Robin-Geissler/EMG-Sensor-Board/Data Sheets/Power Supply/NFM31PC276B0J3L.png

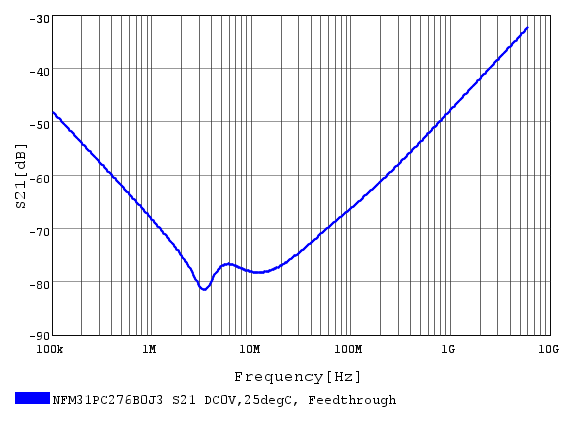
Data Sheets/Power Supply/NFM31PC276B0J3L.png
