Robin-Geissler/EMG-Sensor-Board/Figures/ads1299_config.PNG

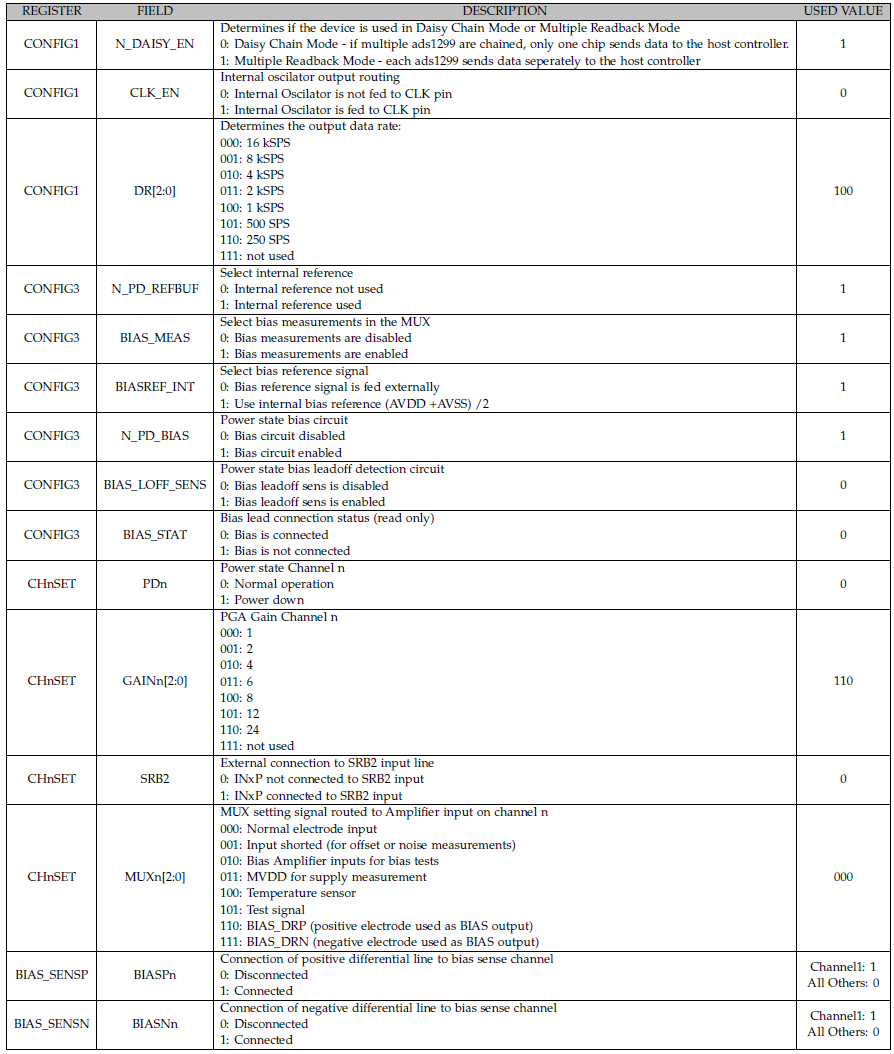
Figures/ads1299_config.PNG
