Robin-Geissler/EMG-Sensor-Board/Figures/8_channel_measurement.PNG

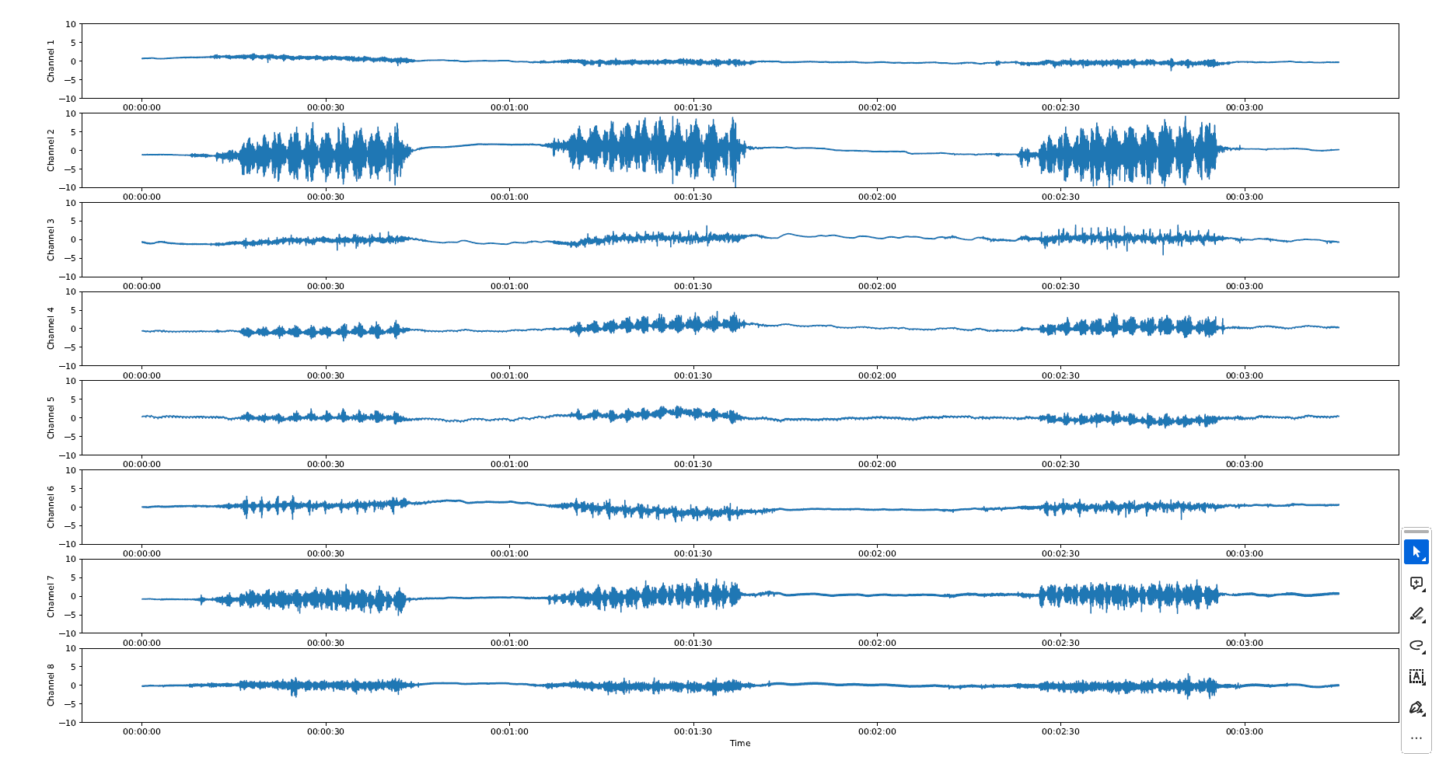
Figures/8_channel_measurement.PNG
