Robin-Geissler/EMG-Sensor-Board/Simulation/ne_measure_Amplitude.pdf

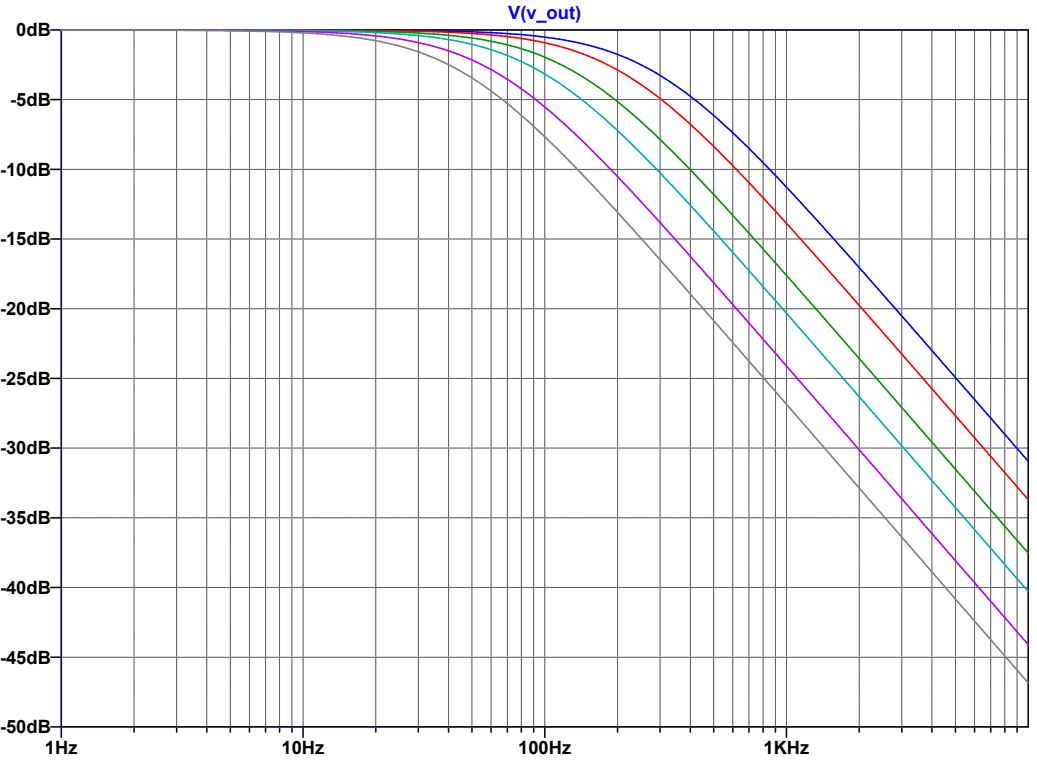
[picture p5: page 1]
1KHz; V(v_out)

--- C:\Projects\emg-sensor_board\Simulation\Filter_RC_Suggested.asc ---
