Robin-Geissler/EMG-Sensor-Board/Simulation/new_measure_Phase.pdf

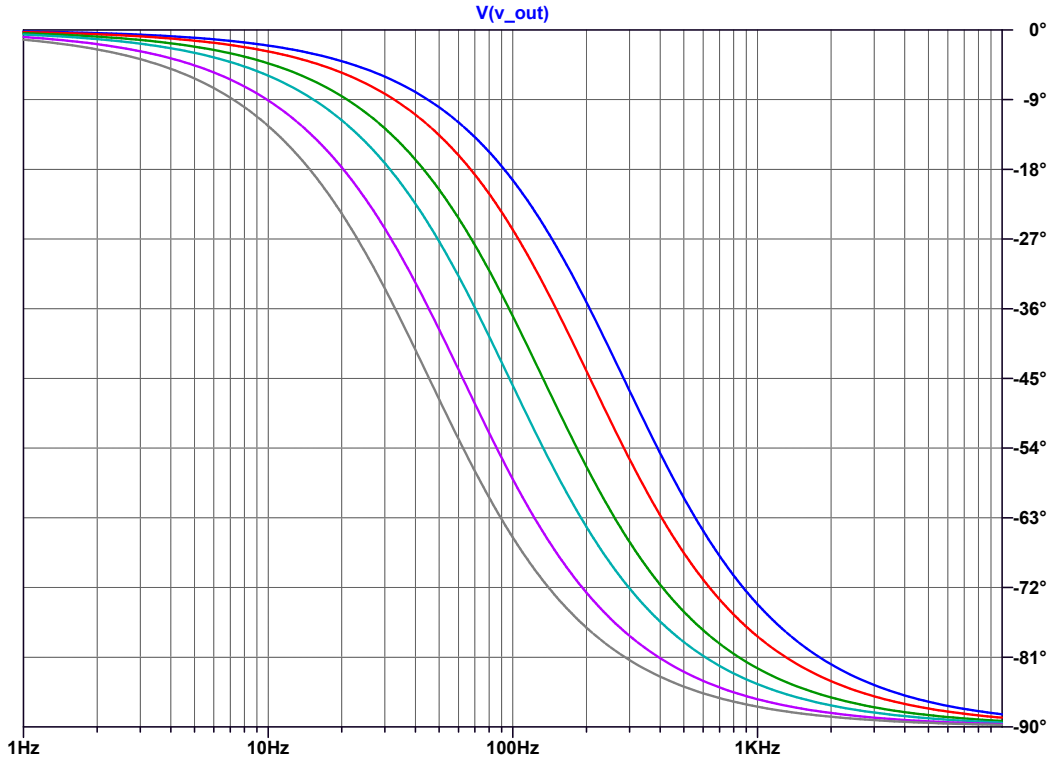
[picture p7: page 1]
1KHz; V(v_out)

--- C:\Projects\emg-sensor_board\Simulation\Filter_RC_Suggested.asc ---
