Robin-Geissler/EMG-Sensor-Board/EMG_Sensor_Board/EMG_Sensor_Board.pdf

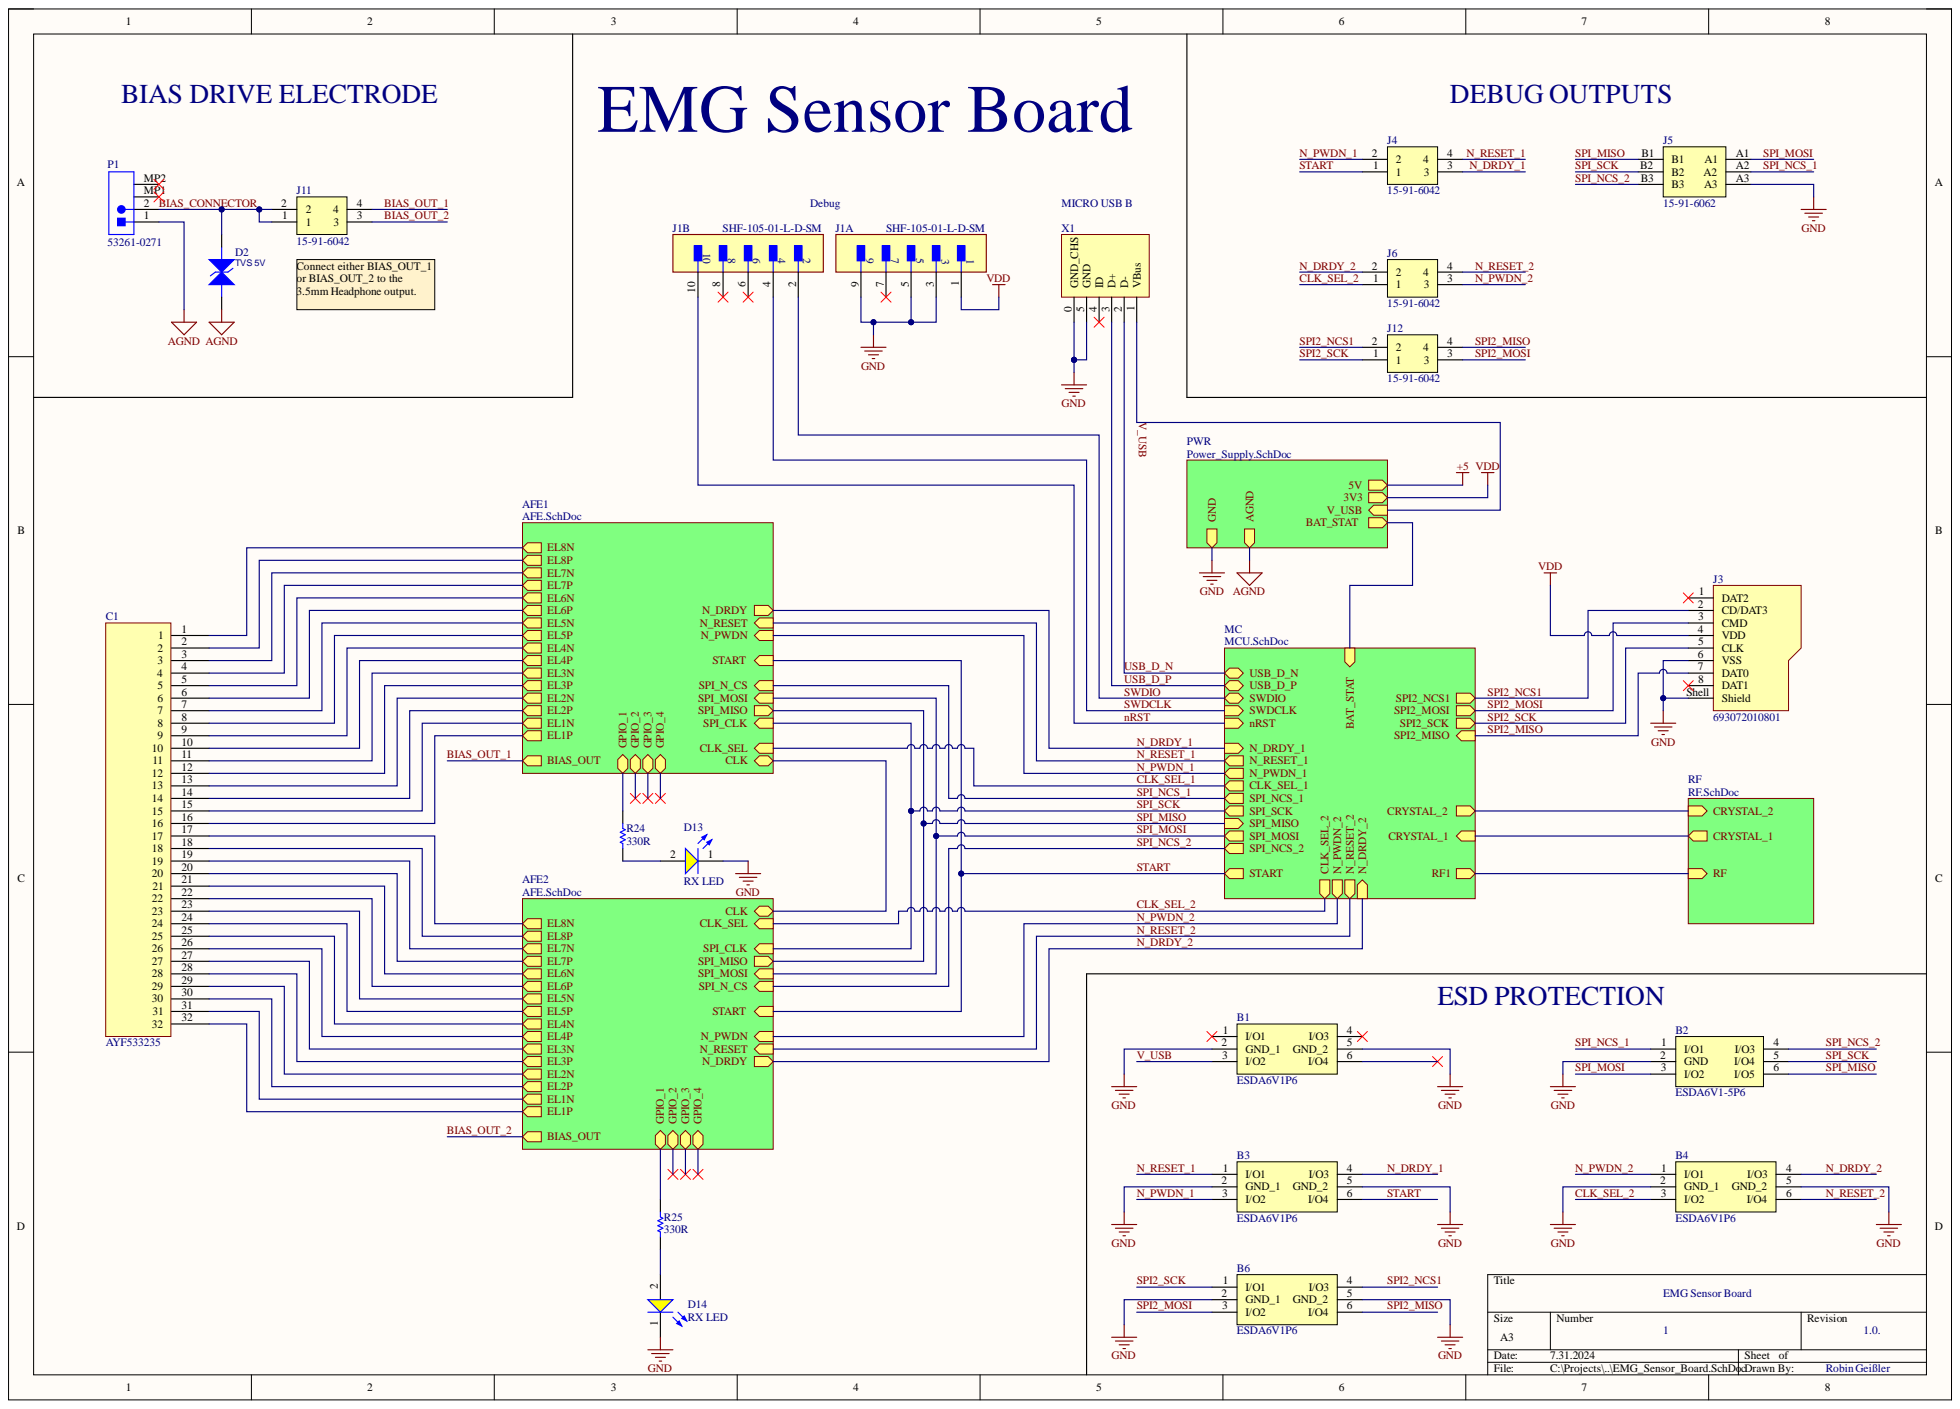
[picture p8: page 1]

5V 3V3 V_USB

BAT_STAT

V_USB | I/O2 3 I/O4 | 6

SPI_MOSI | I/O2 3
