Robin-Geissler/EMG-Sensor-Board/EMG_Sensor_Board/Power_Supply.pdf

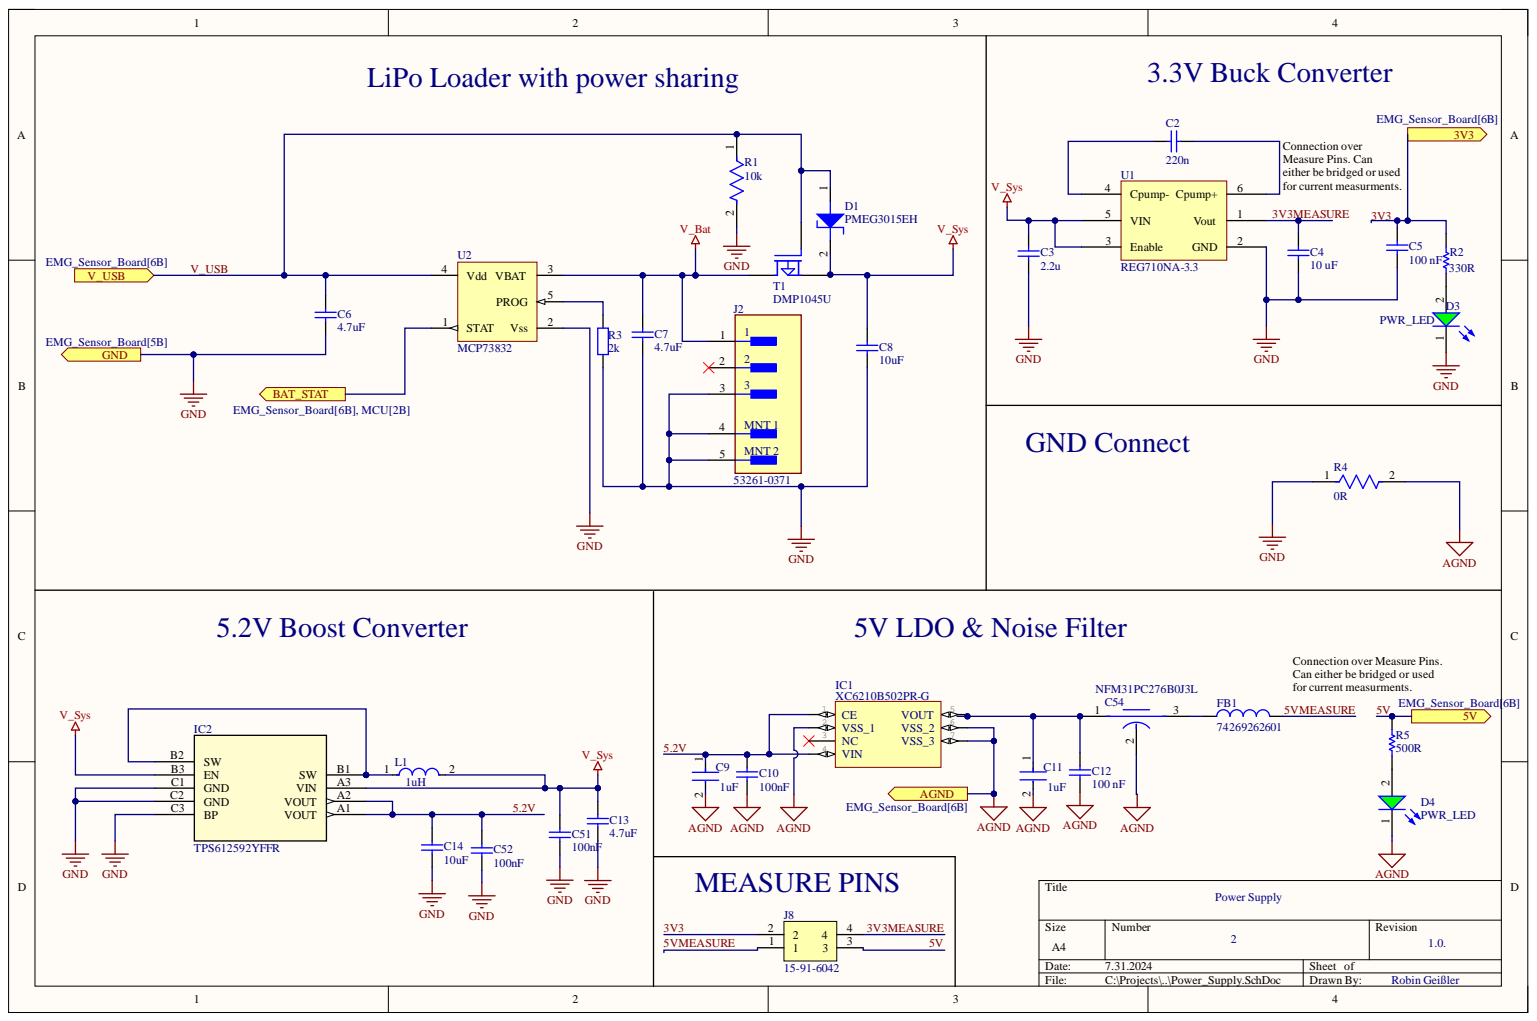
[picture p9: page 1]

LiPo Loader with power sharing

Connection over
Measure Pins. Can
either be bridged or used
for current measurments.

Connection over Measure Pins.
Can either be bridged or used

GND C1
GND C2
BP C3 | 5.2V
