Robin-Geissler/EMG-Sensor-Board/EMG_Sensor_Board/AFE.pdf

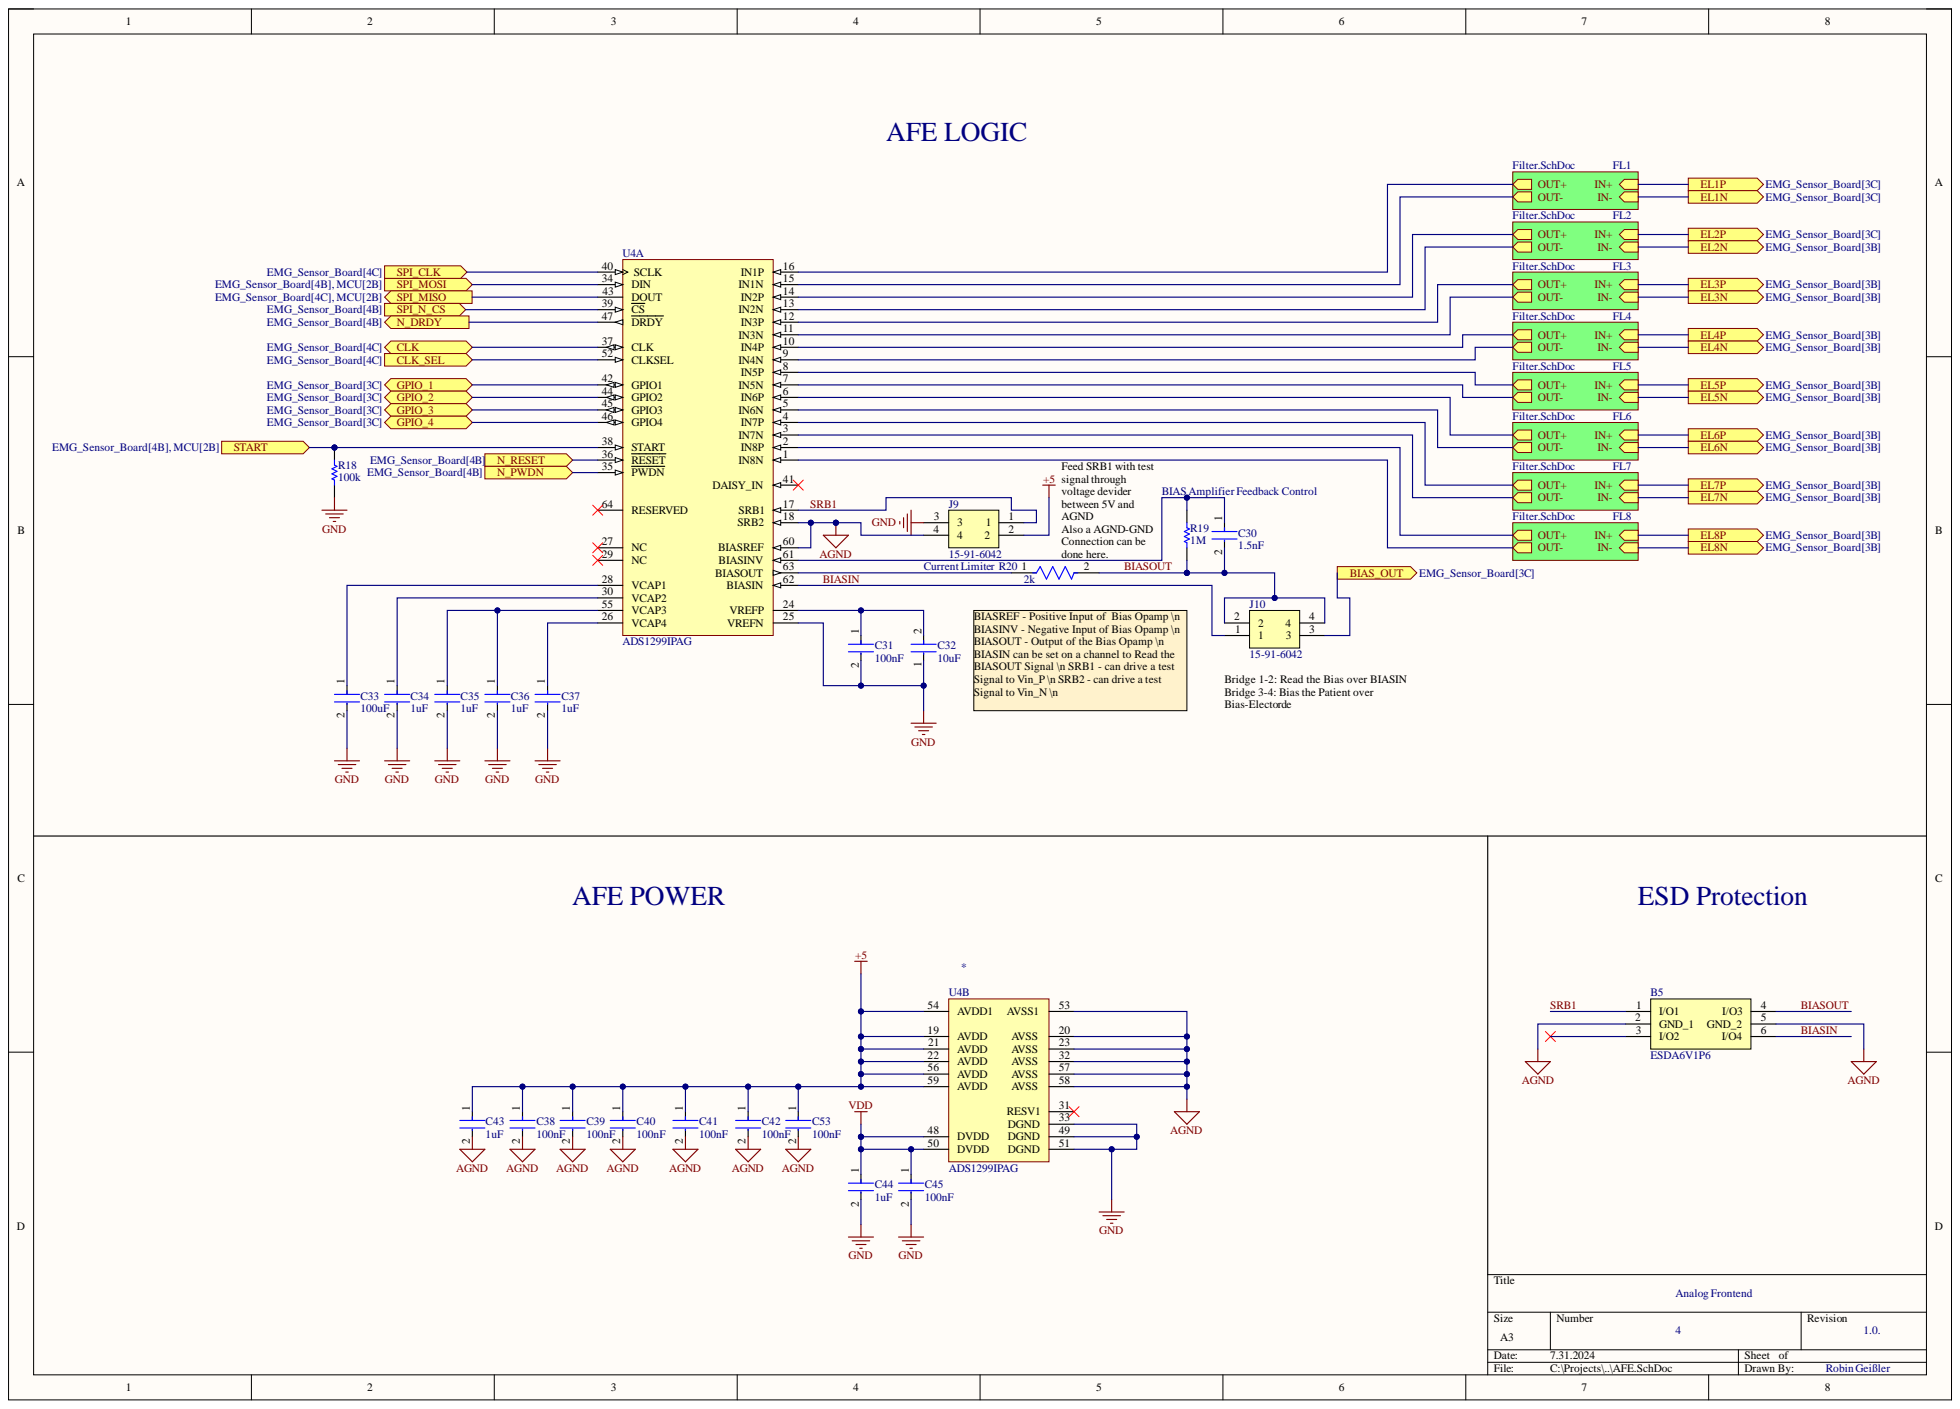
[picture p11: page 1]

BIAS Amplifier Feedback Control

4 4 | OUT+ IN+ OUT-IN-

Connection can be | 1M

BIASREF - Positive Input of Bias Opamp \n
BIASINV - Negative Input of Bias Opamp \n
BIASOUT - Output of the Bias Opamp \n
BIASIN can be set on a channel to Read the
BIASOUT Signal \n SRB1 - can drive a test
Signal to Vin_P \n SRB2 - can drive a test
Signal to Vin_N \n

Bridge 1-2: Read the Bias over BIASIN
Bridge 3-4: Bias the Patient over
Bias-Electorde
