Robin-Geissler/EMG-Sensor-Board/EMG_Sensor_Board/Filter.pdf

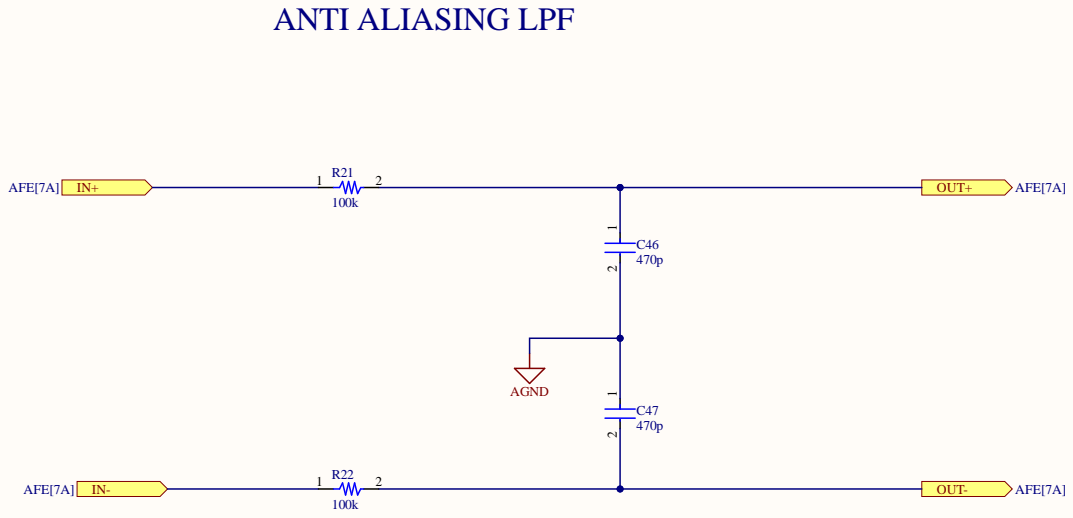
[picture p12: page 1]
