Robin-Geissler/EMG-Sensor-Board/EMG_Sensor_Board/MCU.pdf

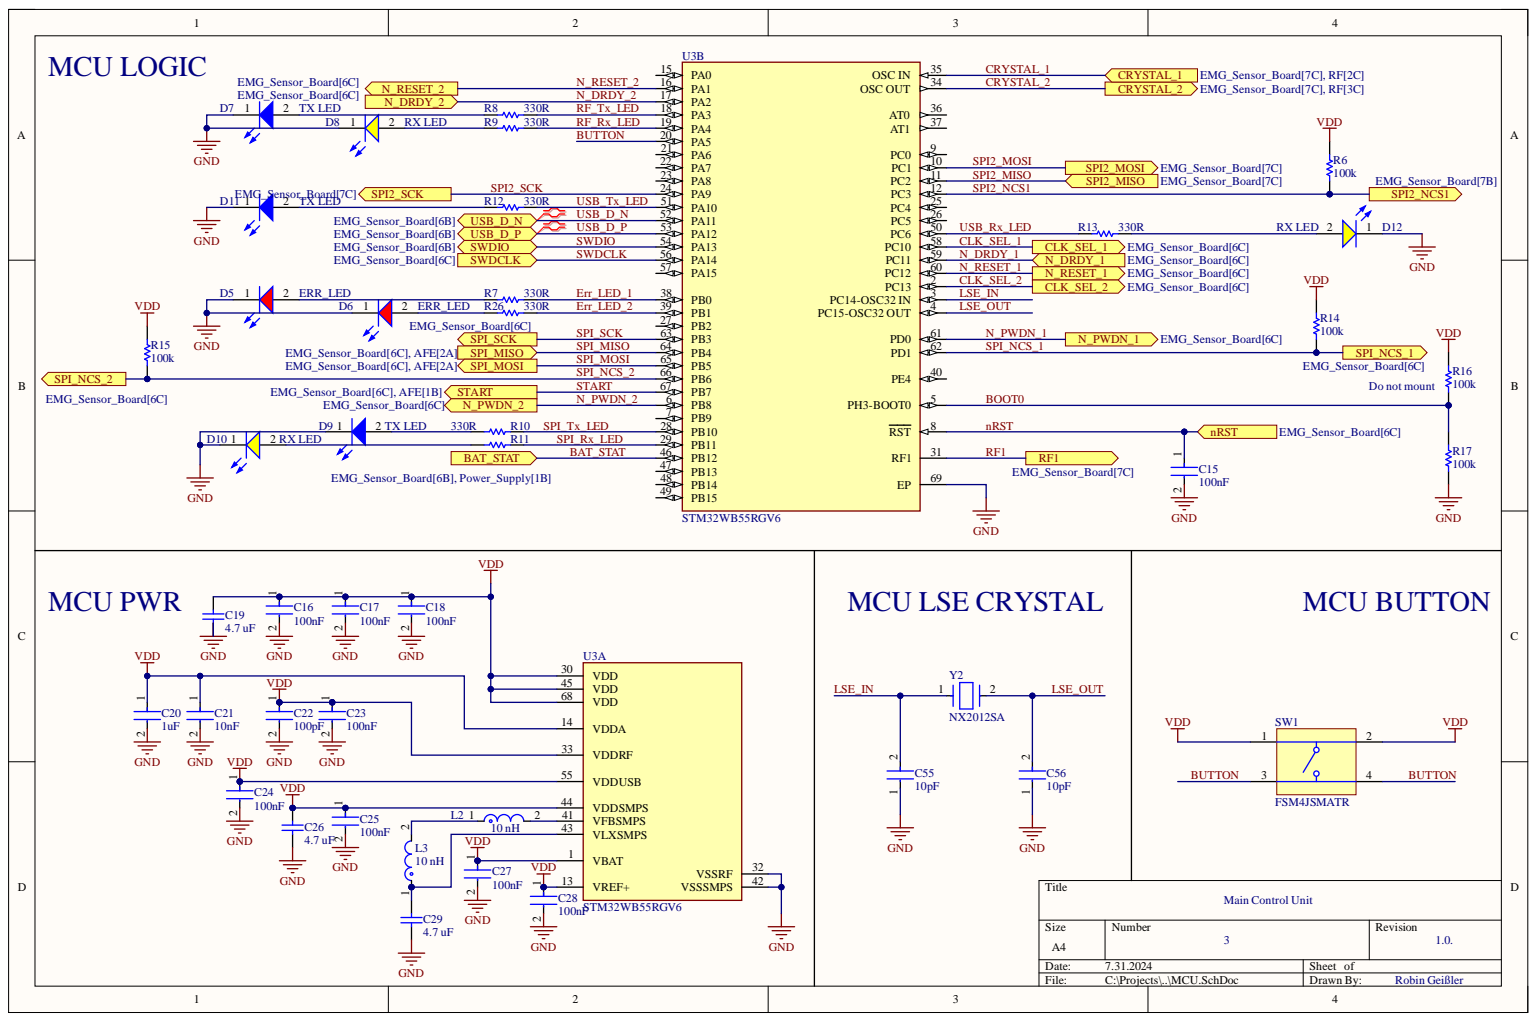
[picture p13: page 1]

VDD 68

VDDA 14

VDDSMPS 44
VFBSMPS 41 VLXSMPS 43

VDD | | VBAT 1
