Robin-Geissler/EMG-Sensor-Board/EMG_Sensor_Board/RF.pdf

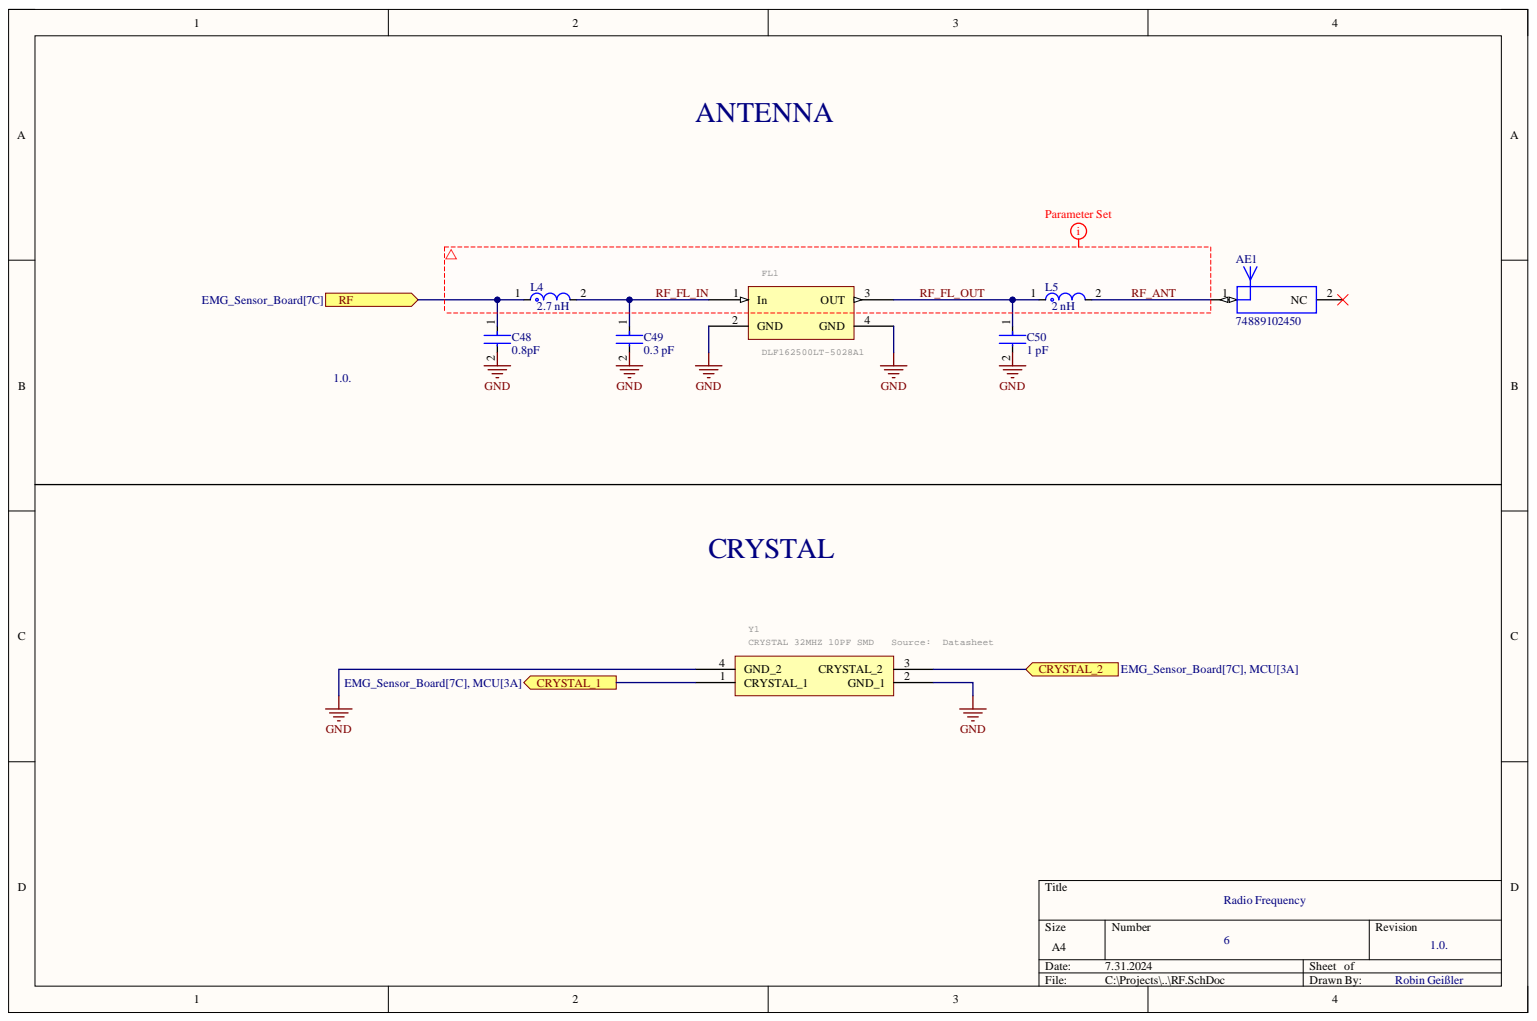
[picture p14: page 1]
