Robin-Geissler/EMG-Sensor-Board/Simulation/Filter_RC_Suggested.asc

C1: cap; {Y}
C2: cap; {Y}
R1: res; 1000Meg
R2: res; {X}
R3: res; {X}
V1: voltage; ""; AC 1; Rser=500k
Named nets: V_out, V_in, 0
.ac dec 100 1 10k
.step param X list 4.99k 100k
.step param Y list 2.2n 4.7n 10n
