Robin-Geissler/EMG-Sensor-Board/Simulation/Filter_RC_Optimal.asc

C1: cap; 318p
C2: cap; 318p
R1: res; 1000Meg
R2: res; 500k
R3: res; 500k
V1: voltage; ""; AC 1; Rser=500k
Named nets: 0, V_out, V_in
.ac dec 100 1 10k
