Robin-Geissler/EMG-Sensor-Board/(list of files, drawings)

Other design files:
EMG_Sensor_Board/AFE.SchDoc
EMG_Sensor_Board/EMG_Sensor.PcbLib
EMG_Sensor_Board/EMG_Sensor.SchLib
EMG_Sensor_Board/EMG_Sensor_Board.PrjPcb
EMG_Sensor_Board/EMG_Sensor_Board.SchDoc
EMG_Sensor_Board/Filter.SchDoc
EMG_Sensor_Board/MCU.SchDoc
EMG_Sensor_Board/PCB1.PcbDoc
EMG_Sensor_Board/Power_Supply.SchDoc
EMG_Sensor_Board/RF.SchDoc
