Robin-Geissler/EMG-Sensor-Board/Software/Core/Src/main.c

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
/* Includes ------------------------------------------------------------------*/
#include "main.h"
#include "app_fatfs.h"
#include "usb_device.h"

/* USER CODE BEGIN Includes */
#include <string.h>
#include "ads1299.h"
#include "usbd_cdc_if.h"
#include "ff_gen_drv.h"
#include "sd_diskio.h"
/* USER CODE END Includes */

/* USER CODE BEGIN PD */
#define BUFFER1 0
#define BUFFER2 1
/* USER CODE END PD */

RTC_HandleTypeDef hrtc;

SPI_HandleTypeDef hspi1;
SPI_HandleTypeDef hspi2;
DMA_HandleTypeDef hdma_spi1_tx;
DMA_HandleTypeDef hdma_spi1_rx;

TIM_HandleTypeDef htim1;
TIM_HandleTypeDef htim2;

/* USER CODE BEGIN PV */
uint8_t *dataReading;
int32_t dataProcessed[8];
char adc_data_str_buff1[60000];
char adc_data_str_buff2[60000];
char adc_data_str[200];
uint32_t adc_data_count = 0;
uint8_t WRITEBUFFER = BUFFER1;
uint8_t LOCK1 = 0;
uint8_t FULL1 = 0;
uint8_t LOCK2 = 0;
uint8_t FULL2 = 0;
uint8_t RUN = 0;
uint8_t DEMOUNT = 0;
uint8_t MOUNT = 0;
uint32_t timeMeasure[10];
uint32_t buff_i = 0;

/* SD Card*/
FRESULT res;
FIL myFile;

RTC_TimeTypeDef stime;
RTC_DateTypeDef sdate;

char log_file[32] = "Log.csv";

/* USER CODE END PV */

void SystemClock_Config(void);
void PeriphCommonClock_Config(void);
static void MX_GPIO_Init(void);
static void MX_DMA_Init(void);
static void MX_SPI1_Init(void);
static void MX_SPI2_Init(void);
static void MX_RTC_Init(void);
static void MX_TIM2_Init(void);
static void MX_TIM1_Init(void);
/* USER CODE BEGIN PFP */

int16_t FS_FILE_Write(char *data);
FRESULT sd_mount(void);
FRESULT sd_unmount(void);
void buttonTask(void);

/* USER CODE END PFP */

/**
  * @brief  The application entry point.
  * @retval int
  */
int main(void)
{
  /* MCU Configuration--------------------------------------------------------*/

  /* Reset of all peripherals, Initializes the Flash interface and the Systick. */
  HAL_Init();

  /* Configure the system clock */
  SystemClock_Config();

/* Configure the peripherals common clocks */
  PeriphCommonClock_Config();

  /* Initialize all configured peripherals */
  MX_GPIO_Init();
  MX_DMA_Init();
  MX_SPI1_Init();
  MX_SPI2_Init();
  if (MX_FATFS_Init() != APP_OK) {
    Error_Handler();
  }
  MX_USB_Device_Init();
  MX_RTC_Init();
  MX_TIM2_Init();
  MX_TIM1_Init();
  /* USER CODE BEGIN 2 */
	
	/* Init SD Card*/
	BSP_SD_Init();
	
	/* Enable Timer for LEDs */
	HAL_TIM_OC_Start(&htim1, 1);
	
	/* ADS1299 Initialization */
	ADS1299_Init(&hspi1, SPI1_NCS1_GPIO_Port, SPI1_NCS1_Pin, CLK_SEL_1_GPIO_Port, CLK_SEL_1_Pin, false, 
	N_PWDN_1_GPIO_Port , N_PWDN_1_Pin, N_RESET_1_GPIO_Port, N_RESET_1_Pin);
  
	/* activate conversion */
	HAL_GPIO_WritePin(START_GPIO_Port, START_Pin, GPIO_PIN_SET);
	HAL_Delay(100);
	
	
	
  /* USER CODE END 2 */

  /* Infinite loop */
  /* USER CODE BEGIN WHILE */
  while (1)
  {		
			/* SD-Card Writing was activated by button push */
			if(MOUNT){
				/* Init Write file */
				/* Mount SD Card */
				res = sd_mount();
				/* Check if mounting was successfull */
				if(res != FR_OK) {
					HAL_GPIO_WritePin(Error_LED_1_GPIO_Port, Error_LED_1_Pin, GPIO_PIN_SET);
				}
				
				/* Open file in append and write mode */
				res = f_open(&myFile, log_file, FA_OPEN_APPEND | FA_WRITE);
				/* Check if file opening was successfull */
				if(res != FR_OK) {
					HAL_GPIO_WritePin(Error_LED_1_GPIO_Port, Error_LED_1_Pin, GPIO_PIN_SET);
					sd_unmount();
				}
				
				/* Mount was successfull, deactivate MOUNT Flag */
				MOUNT = 0;
				
				/* Write header line to file */
				FS_FILE_Write("timestamp;value1;value2;value3;value4;value5;value6;value7;value8\n");
			}
			
			/* SD Card Writing is active */
			if(RUN){
				/*
				 * Write one of the two write buffers to the sd card. One of the two FULL
				 * Flags is set at any time, the other one is false. The full buffer is
				 * written to the sd-card. The other buffer is filled with new measurement
				 * data at the same time by an interrrupt with higher priority (HAL_SPI_TxRxCpltCallback).
				 */
				if(FULL1){
				/* Mark start write */
				HAL_GPIO_WritePin(SPI_Tx_LED_GPIO_Port, SPI_Tx_LED_Pin, GPIO_PIN_SET);
				/* Write SD Card */
				FS_FILE_Write(adc_data_str_buff1);
				/* Empty data buffer */
				strncpy(adc_data_str_buff1, "",1);
				/* Mark buffer as emptied */
				FULL1 = 0;
				/* Mark write finished */
				HAL_GPIO_WritePin(SPI_Tx_LED_GPIO_Port, SPI_Tx_LED_Pin, GPIO_PIN_RESET);
				}
				if(FULL2){
				/* Mark start write */
  			HAL_GPIO_WritePin(SPI_Tx_LED_GPIO_Port,  SPI_Tx_LED_Pin, GPIO_PIN_SET);
				/* Write SD Card */
				FS_FILE_Write(adc_data_str_buff2);
				/* Empty data buffer */
				strncpy(adc_data_str_buff2, "",1);
				/* Mark buffer as emptied */
				FULL2 = 0;
				/* Mark write finished */
				HAL_GPIO_WritePin(SPI_Tx_LED_GPIO_Port, SPI_Tx_LED_Pin, GPIO_PIN_RESET);
				}
			}
			
			/* SD-Card Writing was deactivated by button push */
			if(DEMOUNT){
				/* Close write file */
				res = f_close(&myFile);
				/* Unmount SD Card*/
				res = sd_unmount();
				/* DEMOUNT was successfull, deactivate DEMOUNT Flag */
				DEMOUNT = 0;
			}
		
    /* USER CODE END WHILE */

    /* USER CODE BEGIN 3 */
  }
  /* USER CODE END 3 */
}

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
/* USER CODE BEGIN 4 */

/*
 * SPI TxCplt Callback
 */
void HAL_SPI_TxCpltCallback(SPI_HandleTypeDef *hspi){
		
	if(hspi == &hspi1){
		HAL_GPIO_WritePin(SPI1_NCS1_GPIO_Port, SPI1_NCS1_Pin, GPIO_PIN_SET);
		HAL_GPIO_WritePin(SPI1_NCS2_GPIO_Port, SPI1_NCS2_Pin, GPIO_PIN_SET);
	}
	if(hspi == &hspi2){
//		HAL_GPIO_WritePin(SPI2_NCS1_GPIO_Port, SPI2_NCS1_Pin, GPIO_PIN_SET);
	}
	// timing requirements
//	HAL_Delay(50);
}


/*
 * SPI TxRxCplt Callback
 */
void HAL_SPI_TxRxCpltCallback(SPI_HandleTypeDef *hspi){
	/* Measurement data was read*/	
	if(hspi == &hspi1){
			
		/* Deactivat SPI CS Pins */	
		HAL_GPIO_WritePin(SPI1_NCS1_GPIO_Port, SPI1_NCS1_Pin, GPIO_PIN_SET); // Pin 1
//	HAL_GPIO_WritePin(SPI1_NCS2_GPIO_Port, SPI1_NCS2_Pin, GPIO_PIN_SET); // Pin 2
			
		/* Convert ADS1299 data format to uint32_t */
		ADS1299_Convert_Data(dataReading,dataProcessed);
		/* Send measurement data over USB interface for live plotting */
		CDC_Transmit_FS((uint8_t*)dataProcessed,32);

		/* If active running is deactivated data is not saved */
		if(!RUN){
			return;
		}
		
		/* Create a timestamp */
		HAL_RTC_GetTime(&hrtc, &stime, RTC_FORMAT_BCD);
		HAL_RTC_GetDate(&hrtc, &sdate,RTC_FORMAT_BCD);
		
		
		/* Write into Buffer. Write either Buffer 1 or Buffer 2*/	
		/* Write to Buffer 1 */
		if(WRITEBUFFER == BUFFER1){
			/* Create formatstring in CSV data format */
			sprintf(adc_data_str_buff1 + buff_i,"%x-%x-%x-%03d;%d;%d;%d;%d;%d;%d;%d;%d \n", stime.Hours, stime.Minutes, stime.Seconds, 999 - (stime.SubSeconds * 1000 / 1024), dataProcessed[0],dataProcessed[1],dataProcessed[2],dataProcessed[3],dataProcessed[4],dataProcessed[5],dataProcessed[6],dataProcessed[7]);
			
			do{
				buff_i++;
			}while(adc_data_str_buff1[buff_i] != NULL);
		}
		
		
		/* Write to Buffer 2 */
		if(WRITEBUFFER == BUFFER2){
			sprintf(adc_data_str_buff2 + buff_i,"%x-%x-%x-%03d;%d;%d;%d;%d;%d;%d;%d;%d \n", stime.Hours, stime.Minutes, stime.Seconds, 999 - (stime.SubSeconds * 1000 / 1024), dataProcessed[0],dataProcessed[1],dataProcessed[2],dataProcessed[3],dataProcessed[4],dataProcessed[5],dataProcessed[6],dataProcessed[7]);
			/* set buff_i to the end of the buffer */
			do{
				buff_i++;
			}while(adc_data_str_buff2[buff_i] != NULL);
		}
		
		/* increase data counter */
		adc_data_count++;
		

		/* if a buffer is full (300 values) switch the buffer*/
		if(adc_data_count >= 300){
			/* Mark current buffer as FULL*/
			if(WRITEBUFFER == BUFFER1){
				FULL1 = 1;
			}
			if(WRITEBUFFER == BUFFER2){
				FULL2 = 1;
			}
			
			/* Set new WRITEBUFFER*/
			if(!FULL1){
					WRITEBUFFER = BUFFER1;
			}
			else if(!FULL2){
					WRITEBUFFER = BUFFER2;
			}else{
					/* Error if Both Buffers are occupied -> timing Issue*/
					HAL_GPIO_WritePin(Error_LED_1_GPIO_Port, Error_LED_1_Pin, GPIO_PIN_SET);
			}
			/* Reset buffer end point */
			buff_i = 0;
			/* Reset data counter */
			adc_data_count = 0;
		}
	}
	
	/* SPI 2 was Read */
	if(hspi == &hspi2){
			/*Implement here what should happen after spi2 read*/
	}
}


/*
 * SPI EXTI Callback
 */
void HAL_GPIO_EXTI_Callback(uint16_t GPIO_Pin){
		switch(GPIO_Pin){
			case N_DRDY_1_Pin:
//				ADS1299_WriteRegister(GPIO, 0xF0);	
				dataReading = ADS1299_RDATA();	
			
				
//				CDC_Transmit_FS((uint8_t*)"hi", 2);
				
//				ADS1299_WriteRegister(GPIO, 0x00);
				break;
			case N_DRDY_2_Pin:
				ADS1299_WriteRegister(GPIO, 0xF0);
				break;
			case Button_Pin:
				 buttonTask();
				break;
			default:
				break;
		}
}

void HAL_TIM_OC_DelayElapsedCallback(TIM_HandleTypeDef *htim){ 
	HAL_GPIO_TogglePin(SPI_Rx_LED_GPIO_Port, SPI_Rx_LED_Pin);
}



/**
* @brief  write data to the file
* @param  filename
* @param  data
* @return status int16_t: bytes_written < 0, FRESULT >=0
*/
int16_t FS_FILE_Write(char *data) {
	FRESULT res;
	
	uint16_t bytes_written;
 
	// 2. write data to file
	// res = f_write(&myFile, data, strlen(data), (void *)&bytes_written);
	bytes_written = f_puts(data, &myFile);
	
	// 5. return status: bytes_written < 0, FRESULT >=0
	return -1 * bytes_written;
}
 
 
/**
* @brief  mount uSD card
* @return FRESULT
*/
FRESULT sd_mount(void) {
	FRESULT res = f_mount(&SDFatFs, SDPath, 1);
	//HAL_Delay(10);
	return res;
}
 
 
/**
* @brief  unmount uSD card
* @return FRESULT
*/
FRESULT sd_unmount(void) {
	return f_mount(0, SDPath, 0);
}

void buttonTask(void){
	
	/* Software debounce*/
	HAL_Delay(10);
	if(!HAL_GPIO_ReadPin(Button_GPIO_Port,  Button_Pin)) return;
	
	/* if not running start run*/
	if(!RUN){
		/* initialize a run*/
		MOUNT = 1;
		RUN = 1;
		
		/* reset time*/
		stime.Hours = 0;
		stime.Minutes = 0;
		stime.Seconds = 0;
		stime.SubSeconds = 0;
		HAL_RTC_SetTime(&hrtc, &stime, RTC_FORMAT_BCD);
		
		/* re-init writing variables*/
		WRITEBUFFER = BUFFER1;
		buff_i = 0;
		adc_data_count = 0;
		
		/* mark running*/
		HAL_GPIO_WritePin(SPI_Rx_LED_GPIO_Port, SPI_Rx_LED_Pin, GPIO_PIN_SET);
		
		return;
	}
	
	
	/* If running, stop run*/
	if(RUN){
		RUN = 0;
		DEMOUNT = 1;
		
		/* RESET Error*/
  	HAL_GPIO_WritePin(Error_LED_1_GPIO_Port, Error_LED_1_Pin, GPIO_PIN_RESET);
		
		/* Mark Not Running*/
		HAL_GPIO_WritePin(SPI_Rx_LED_GPIO_Port, SPI_Rx_LED_Pin, GPIO_PIN_RESET);
		return;
	}
	
}
/* USER CODE END 4 */
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
