Robin-Geissler/EMG-Sensor-Board/(commit log)

2024-01-19 inits project, adds STM
    [AFE.SchDoc, EMG_Sensor_Board.PrjPcb, EMG_Sensor_Board.SchDoc, MCU.SchDoc, Power_Supply.SchDoc]
2024-01-23 adds Power supply (finished), AFE (not finished), MCU (not finished)
    [AFE.SchDoc, EMG_Sensor_Board.PrjPcb, EMG_Sensor_Board.SchDoc, MCU.SchDoc, Power_Supply.SchDoc, USB_C.SchDoc]
2024-01-24 some changes on AFEs
    [AFE.SchDoc, MCU.SchDoc, Power_Supply.SchDoc, USB_C.SchDoc]
2024-01-26 changes on mcu and init of ioc file
    [EMG_Sensor_Board.PrjPcb, EMG_Sensor_Board.SchDoc, MCU.SchDoc, PCB1.PcbDoc, Power_Supply.SchDoc]
2024-01-26 adds basics for battery loader
    [Power_Supply.SchDoc]
2024-02-02 new power supply 5.2V
    [AFE.SchDoc, DSBGA09_1P206X1P306_TEX.step, EDI2CAP.CFG, PADS Libraries.PrjPcb, Power_Supply.SchDoc, TPS612592YFFR.PcbLib, TPS612592YFFR.SchLib, XC6210B502PR-G.Library.PrjPcb]
2024-02-06 adds basic simulation for Signal Filters
    [AFE.SchDoc, Power_Supply.SchDoc, XC6210B502PR-G.Library.PrjPcb, XC6210B502PR-G.PCBLIB, XC6210B502PR-G.SCHLIB]
2024-02-07 exchanges stm32 SOC with STM32 Microcontroller that has different package
    [AFE.SchDoc, MCU.SchDoc]
2024-02-08 work on AFE, and STM32
    [AFE.SchDoc, MCU.SchDoc, Power_Supply.SchDoc, USB_C.SchDoc]
2024-02-11 adds RF circuitry
    [DLF162500LT-5028A1.Library.PrjPcb, DLF162500LT-5028A1.PCBLIB, DLF162500LT-5028A1.SCHLIB, DLF162500LT-5028A1.stp, EDI2CAP.CFG, EMG_Sensor_Board.SchDoc, MCU.SchDoc, NX2016SA-32M-EXS00A-CS06465.Library.PrjPcb]
2024-02-15 starts connecting main sheet
    [AFE.SchDoc, EMG_Sensor.SchLib, EMG_Sensor_Board.PrjPcb, EMG_Sensor_Board.SchDoc, ENG_Sensor.PcbLib, Filter.SchDoc, MCU.SchDoc, PcbLib1.PcbLib]
2024-02-16 changes in EMG Sensor Library
    [AFE.SchDoc, EMG_Sensor.SchLib, EMG_Sensor_Board.PrjPcb, EMG_Sensor_Board.SchDoc, ENG_Sensor.PcbLib, Filter.SchDoc, MCU.SchDoc, Power_Supply.SchDoc]
2024-02-17 adds connections in main sheet
    [AFE.SchDoc, EMG_Sensor_Board.SchDoc, MCU.SchDoc, RF.SchDoc]
2024-02-19 adds RLD circuit, measurment headers, LEDs
    [AFE.SchDoc, EMG_Sensor.SchLib, EMG_Sensor_Board.SchDoc, Filter.SchDoc, MCU.SchDoc, Power_Supply.SchDoc]
2024-02-19 adds changes in simulation comparing option with low tolerance resistors
2024-02-19 adds LEDs in software configuration
2024-02-19 updates filter simulation
2024-02-20 adds Electrode Connector
    [AYF531635.Library.PrjPcb, AYF531635.PCBLIB, AYF531635.PcbLib, AYF531635.SCHLIB, AYF531635.SchLib, AYF531635.stp, EDI2CAP.CFG, EMG_Sensor.SchLib]
2024-02-20 adds connector for Bias Drive, some caps in power supply, general organization
    [AFE.SchDoc, EDI2CAP.CFG, EMG_Sensor.SchLib, EMG_Sensor_Board.PrjPcb, EMG_Sensor_Board.SchDoc, ENG_Sensor.PcbLib, Filter.SchDoc, MCU.SchDoc]
2024-02-21 resolves D1 footprint issue
    [EMG_Sensor.SchLib, EMG_Sensor_Board.PrjPcb, ENG_Sensor.PcbLib, Power_Supply.SchDoc]
2024-02-22 5.2V Caps, ESD Protection, Footprint correction for precision resistor...
    [EMG_Sensor.SchLib, EMG_Sensor_Board.PrjPcb, EMG_Sensor_Board.SchDoc, ENG_Sensor.PcbLib, Filter.SchDoc, MCU.SchDoc, Power_Supply.SchDoc]
2024-02-27 routing AFEs, Filters, MCU
    [AFE.SchDoc, EMG_Sensor_Board.PrjPcb, EMG_Sensor_Board.SchDoc, Filter.SchDoc, MCU.SchDoc, Power_Supply.SchDoc]
2024-02-28 part placement Power, RF, Routing Input Signals, Boardshape, Board Compression
    [ENG_Sensor.PcbLib, Power_Supply.SchDoc]
2024-02-29 new bias electrode connector, some Power Routing
    [EMG_Sensor_Board.PrjPcb, EMG_Sensor_Board.SchDoc]
2024-03-01 space optimization, power routing
    [Power_Supply.SchDoc]
2024-03-04 routing spi
    [AFE.SchDoc, EMG_Sensor_Board.SchDoc, MCU.SchDoc]
2024-03-05 routing of ESD protection + RF Final
    [EMG_Sensor_Board.SchDoc, RF.SchDoc]
2024-03-08 adds descriptions on silk screen + some rule violation resolvements
    [EMG_Sensor_Board.PrjPcb, EMG_Sensor_Board.SchDoc, ENG_Sensor.PcbLib]
2024-03-11 adds testing LEDs for AFEs
    [EMG_Sensor_Board.SchDoc]
2024-03-14 new LTSpice filter simulation + lettle changes in layout from ferdis design review (more changes to come)
    [EMG_Sensor_Board.PrjPcb]
2024-03-15 adds SD Card connector and rearranges DEBUG Connector and LEDs
    [AFE.SchDoc, EMG_Sensor_Board.SchDoc, MCU.SchDoc, Power_Supply.SchDoc, RF.SchDoc]
2024-03-18 some DRC Error resolvement
    [Software.ioc]
2024-03-19 new button + spi2 debug connectors
    [EMG_Sensor_Board.PrjPcb, EMG_Sensor_Board.SchDoc, MCU.SchDoc]
2024-03-21 rearrangement of power supply for clear Analog Digital separation, adds LS Crystal for realtime clock, adds more filtering to 5V PWR over broader frequency span
    [AFE.SchDoc, EMG_Sensor.SchLib, EMG_Sensor_Board.PrjPcb, EMG_Sensor_Board.SchDoc, ENG_Sensor.PcbLib, MCU.SchDoc, Power_Supply.SchDoc]
2024-03-24 new naming of files, and annotation of the pcb
    [EMG_Sensor.PcbLib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]
2024-03-24 adds output job
    [AFE.SchDoc, EMG_Sensor.PcbLib, EMG_Sensor_Board.SchDoc, Filter.SchDoc, MCU.SchDoc, Power_Supply.SchDoc, RF.SchDoc]
2024-04-02 resolves issues with part drawings on multiple layers in library
    [EMG_Sensor.PcbLib, EMG_Sensor_Board.PrjPcb]
2024-05-07 generated setup software, implemented general read and write functions for the AFEs over SPI
2024-05-10 spi signal configured with dma, power up or signal still not correct
    [Software.ioc, ads1299.c, main.c, main.h]
2024-05-14 adds basic spi communication to AFE
2024-05-22 resolves bugs: 1. debuggingImpossible: HeapSize back to normal 2. data formatting bug
    [Software.ioc, ads1299.c, main.c]
2024-05-24 resolves bug, correctly calculates 2-compliment data format from 3 to 4 bytes
    [ads1299.c, main.c]
2024-06-06 adds configuration for RLD Electrode
2024-07-28 adds fixes GND uC + GND LED
    [MCU.SchDoc, Power_Supply.SchDoc]
2024-08-26 adds PCB.svg
2024-09-03 Upload filter svg for wiki
2024-09-03 Upload power supply svg
2024-09-04 deleted unnessecary files
    [AFE.SchDoc, AYF531635.Library.PrjPcb, AYF531635.PCBLIB, AYF531635.PcbLib, AYF531635.SCHLIB, AYF531635.SchLib, AYF531635.stp, DLF162500LT-5028A1.Library.PrjPcb]
2024-09-04 adds schematics in pdf format
2024-09-04 puts PCB Design Rules to data sheets
