Robin-Geissler/EMG-Sensor-Board/(notices)

Notices in the files:
Software/Core/Src/main.c:
Copyright (c) 2024 STMicroelectronics.
All rights reserved.
